nelson40514/em-2_mount/K-P43G.pdf

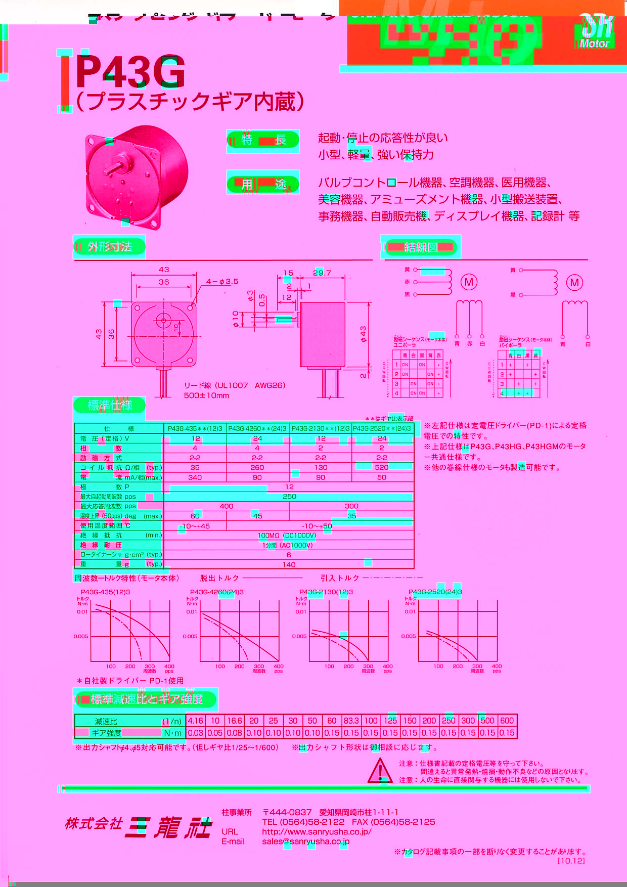
[picture p2: page 1]
