nelson40514/em-2_mount/PCB_Layout.jpg

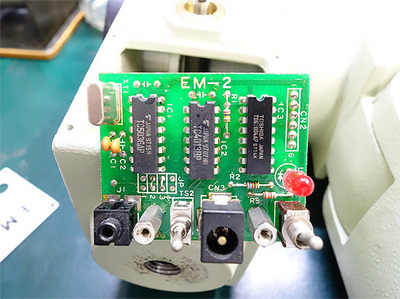
PCB_Layout.jpg
