nelson40514/em-2_mount/stepper_motor.jpg

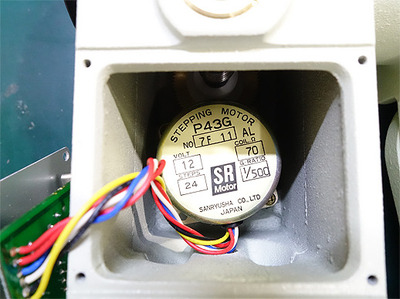
stepper_motor.jpg
