nelson40514/em-2_mount/PCB_Layout.pdf

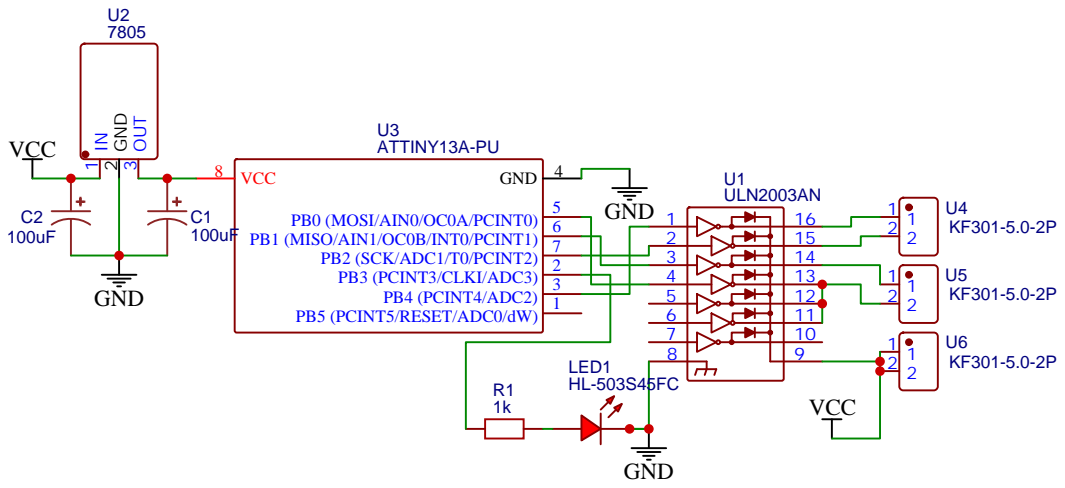
[picture p5: page 1]
