nelson40514/em-2_mount/(commit log)

2021-03-11 上傳Arduino程式
2021-03-11 網路上的零件素材
2021-03-11 Readme編輯
    將系統進行簡略介紹
2021-03-11 Hackmd與Github連結
